z2amiller/ocn-LCD/FABLOG.md

# Fab Log

| Date | Board | Rev | Gen | Gerber SHA256 | JLC Order # | Notes |
|---|---|---|---|---|---|---|
| 2026-10-07T20:06 | ocn-LCD | 0.1 | 2 | ee7b4f2be727 | | |
| 2026-11-05T18:08 | ocn-LCD | 0.2 | 3 | 35a1b2744513 | | |
| 2026-11-05T18:33 | ocn-LCD | 0.2 | 4 | 9f6a66332300 | | |
| 2026-11-05T19:47 | ocn-LCD | 0.2 | 5 | 936187ad2718 | | |
| 2026-11-06T17:15 | ocn-LCD | 0.2 | 6 | 7f4fd457bffb | | |
