z2amiller/ocn-LCD/docs/ORDERING.md

# Ordering assembled boards from JLCPCB

JLCPCB can make the board and fit every surface-mount part. You only need three files from this
repo. On GitHub, open each one and use its download button:

- [`GERBER-ocn-LCD.zip`](../GERBER-ocn-LCD.zip): the board itself
- [`BOM-ocn-LCD.csv`](../jlcpcb/production_files/BOM-ocn-LCD.csv): the parts list, with an LCSC part number for each part
- [`CPL-ocn-LCD.csv`](../jlcpcb/production_files/CPL-ocn-LCD.csv): where each part goes on the board

Five assembled boards came to about $49 in November 2026, before shipping. JLC doesn't fit the LCD,
the programming header or the battery. Those come afterwards; see [Assembly](../README.md#assembly)
in the README.

## 1. Upload the gerber zip

Start at [jlcpcb.com](https://jlcpcb.com) and add `GERBER-ocn-LCD.zip`. The size and layer count fill
in from the file.

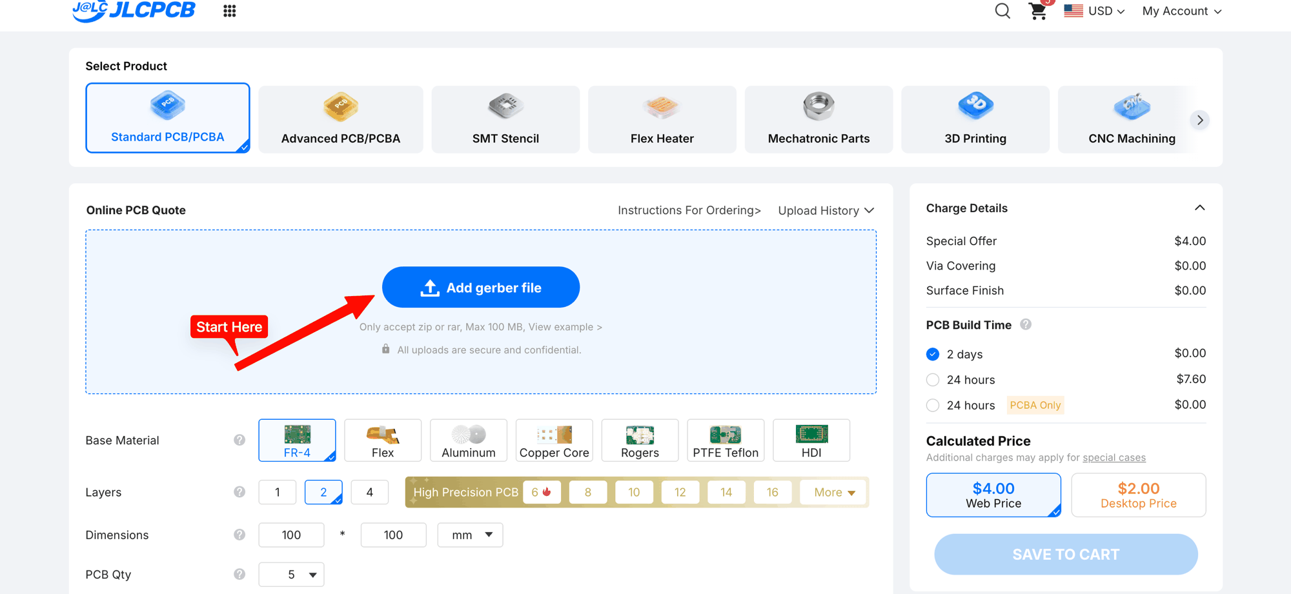
[picture p3: docs/ordering/01-upload-gerber.png]
Add gerber file


## 2. Board options

Change the surface finish to **LeadFree HASL**. Leave everything else at its default. You can pick
another soldermask colour if you like.

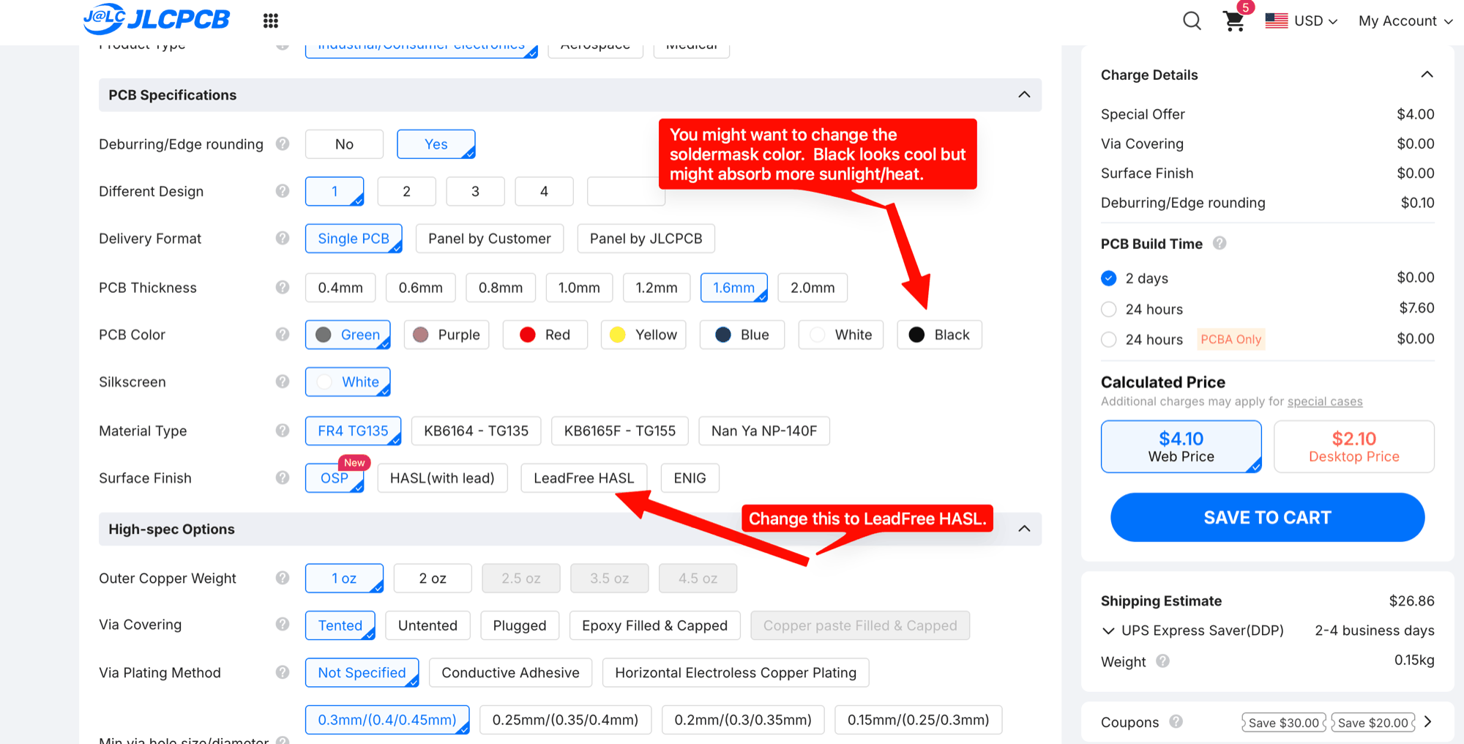
[picture p4: docs/ordering/02-pcb-options.png]
PCB specifications


## 3. Optional: a QR code serial number

The back of the board has an 8 × 8 mm silkscreen box. Choose **2D barcode (Serial Number)** under
*Mark on PCB* and JLC prints a unique QR code in that box.

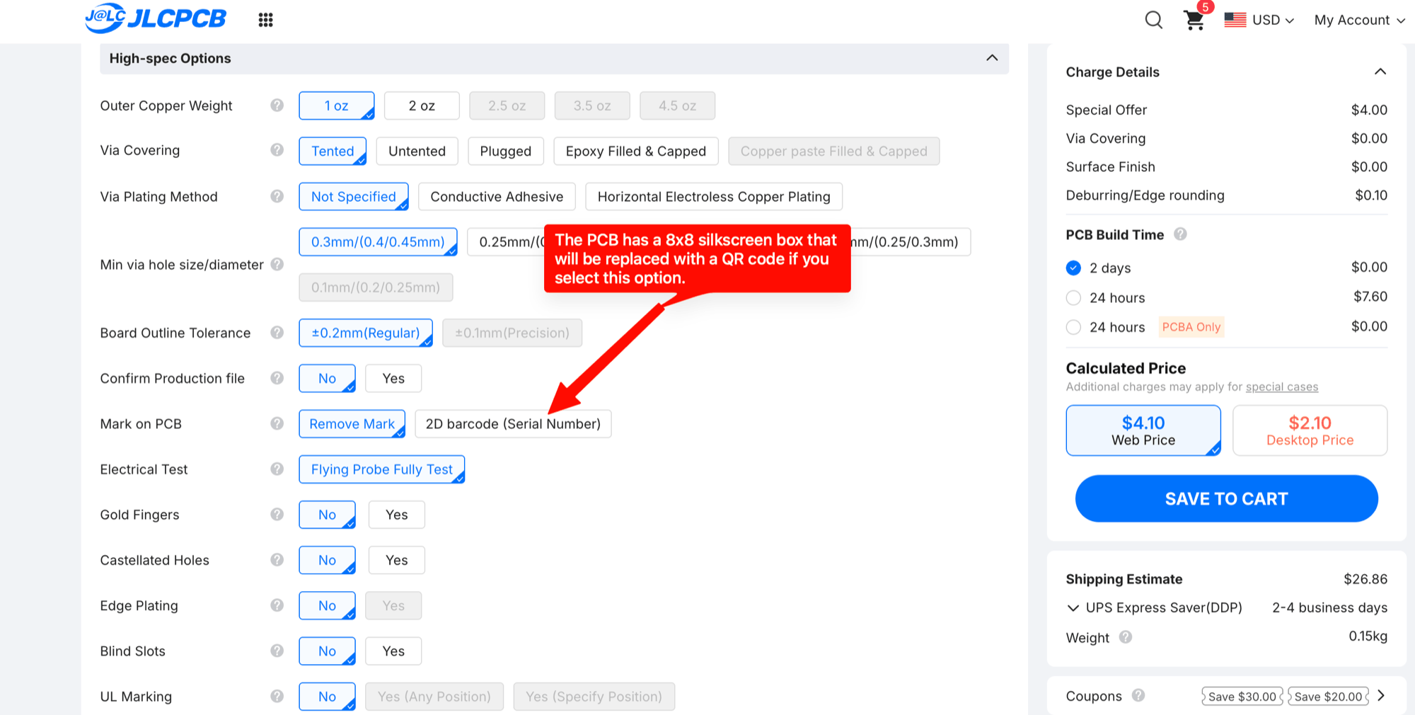
[picture p5: docs/ordering/03-mark-on-pcb.png]
Mark on PCB


In the dialog, pick **8\*8mm** and **Specify Position** so the code lands in the box. The prefix is
up to you.

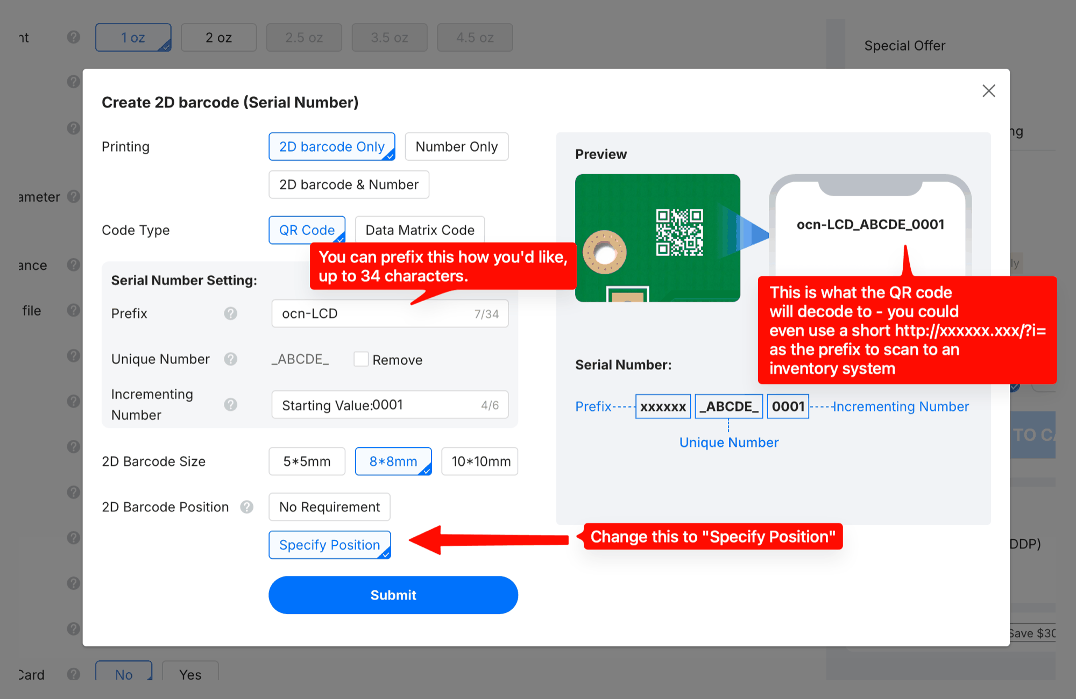
[picture p6: docs/ordering/04-serial-number.png]
2D barcode settings


## 4. Turn on assembly

Turn on the PCB Assembly switch. Choose **Economic**, **Top Side**, and the number of boards you
want assembled. If Economic isn't available, check that the board thickness and copper weight are
still at their defaults.

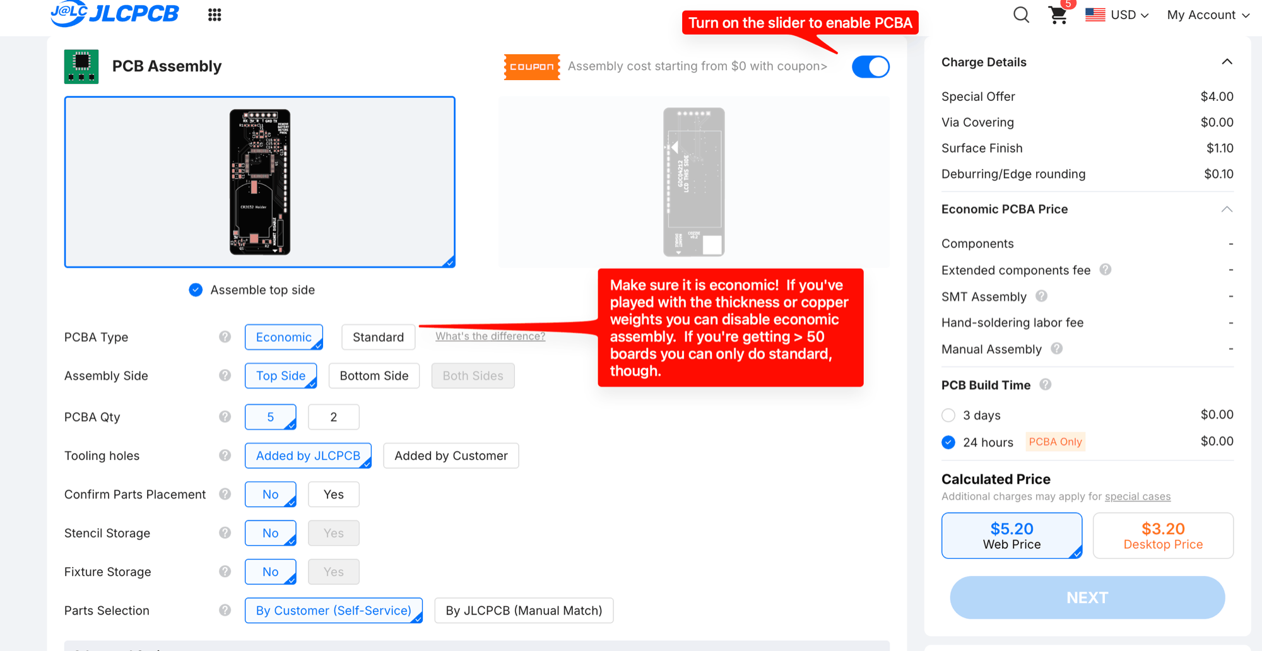
[picture p7: docs/ordering/05-pcb-assembly.png]
PCB Assembly options


## 5. Optional: approve JLC's work before they build

Two options make JLC wait for your approval before going ahead. Both are off by default.

- **Confirm Production file**, under *High-spec Options* in step 3. JLC sends you the board files
  after its engineers have processed them, and you approve them before the board is made.
- **Confirm Parts Placement**, under the assembly options in step 4. JLC's engineers check where and
  which way round each part sits, and send you a picture to approve before assembly.

Together they add about $1.50, plus however long you take to reply. The total in step 10 includes
both. The author leaves them off for these files, because they're already checked and step 9 shows
the placement anyway. They're worth turning on if you've changed the board.

## 6. Overview

The next page is a summary. Click **Next**.

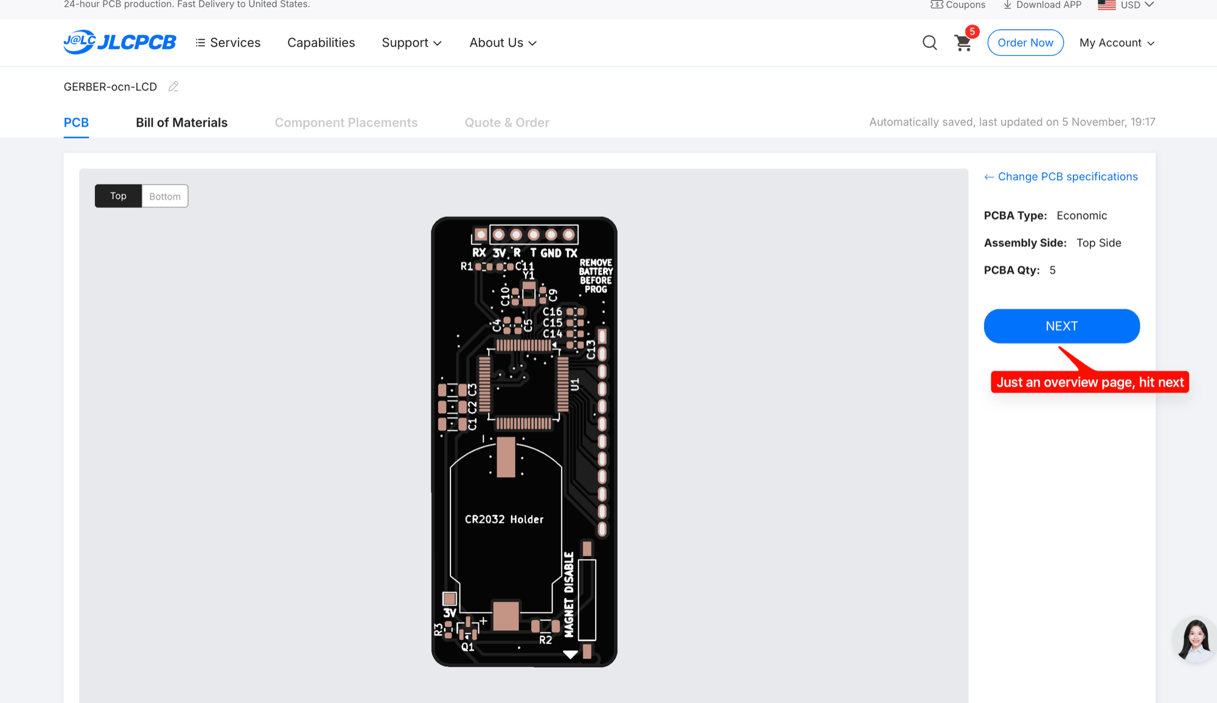
[picture p8: docs/ordering/06-overview.png]
Overview page


## 7. Upload the BOM and placement files

Add `BOM-ocn-LCD.csv` and `CPL-ocn-LCD.csv`, then click **Process BOM & CPL**.

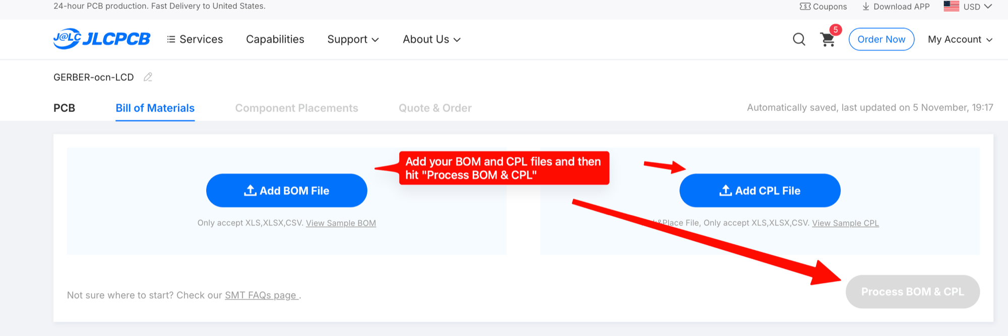
[picture p9: docs/ordering/07-upload-bom-cpl.png]
Add BOM and CPL files


## 8. Check the parts

All 12 lines should be matched, in stock and ticked. If a part is out of stock, find a replacement
on JLC's main parts search, which works better than the search on this page.

Two lines in the screenshot say *My Parts* because they came out of the author's own JLC stock. On
your order they will come from JLCPCB.

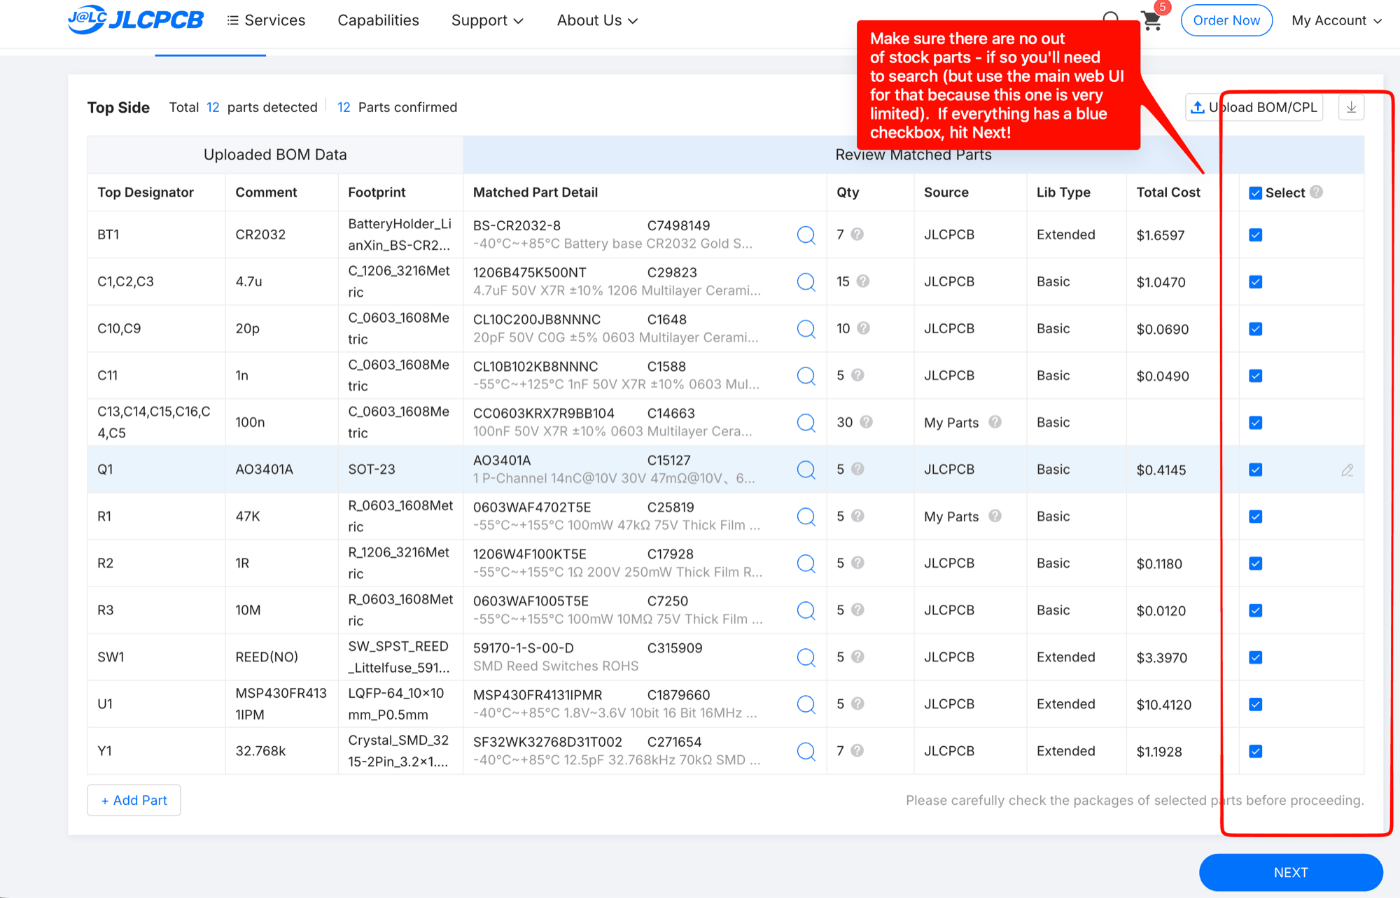
[picture p10: docs/ordering/08-check-parts.png]
Matched parts


## 9. Check the placement

Look over the preview for parts at the wrong angle, especially the transistor (Q1) and the
microcontroller (U1). To fix one, select it and press Space to turn it 90°.

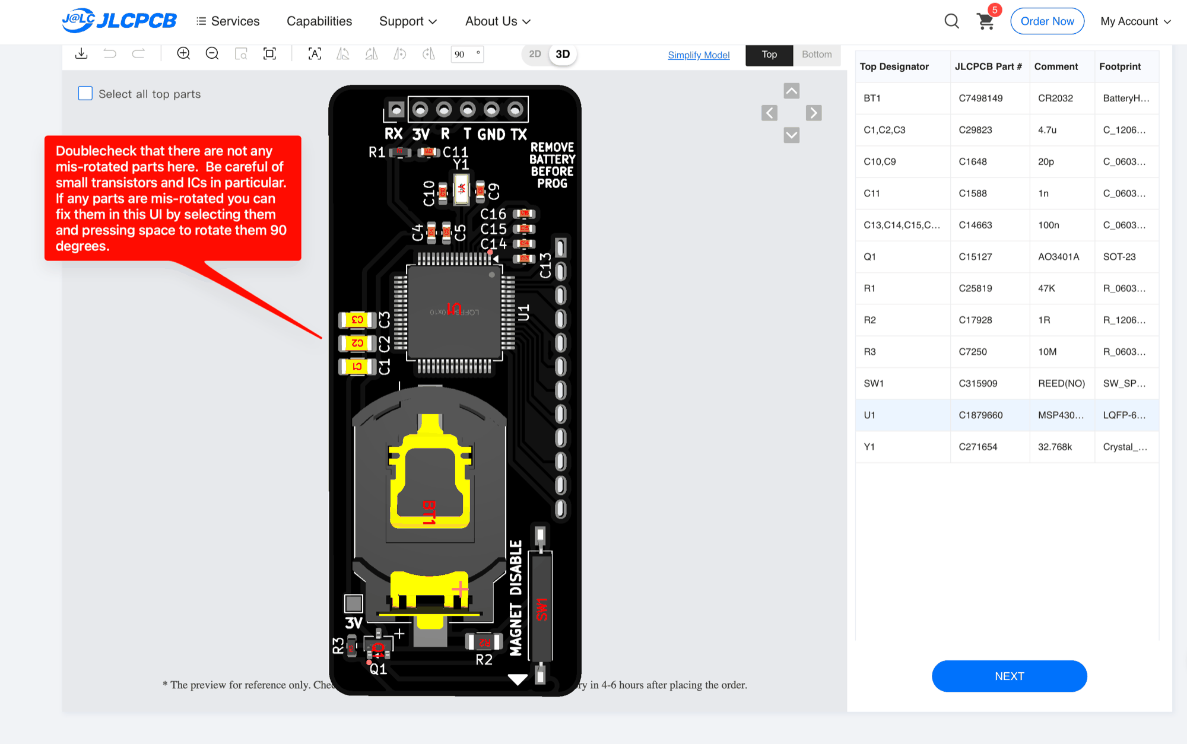
[picture p11: docs/ordering/09-check-placement.png]
Placement preview


## 10. Save to cart

The last page shows the total. You may need to choose a product description before it lets you save.
"Sensors → Clock" works. Then **Save to Cart** and check out as usual.

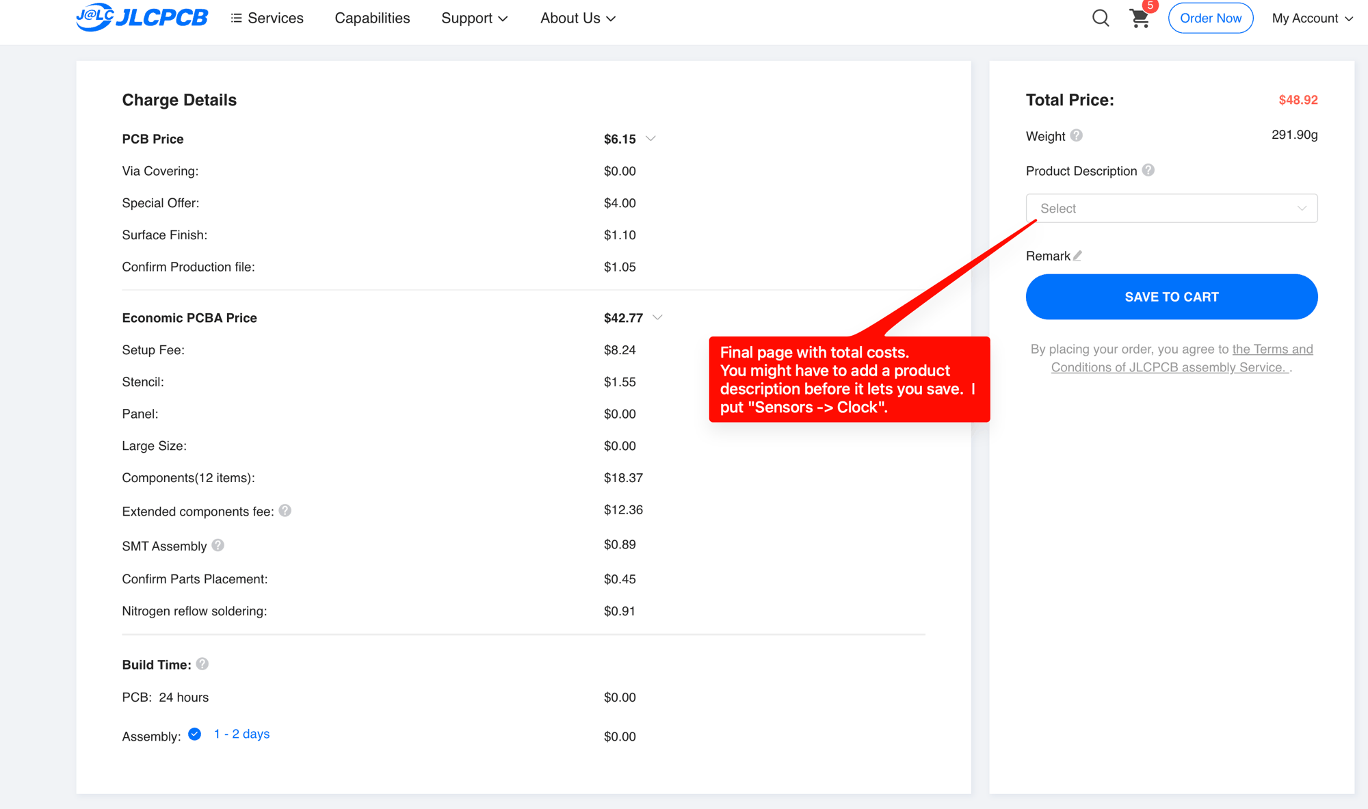
[picture p12: docs/ordering/10-total.png]
Charge details
