z2amiller/ocn-LCD/jlcpcb/production_files/BOM-ocn-LCD.csv

Comment | Designator | Footprint | LCSC | Quantity
100n | C13,C14,C15,C16,C4,C5 | C_0603_1608Metric | C14663 | 6
10M | R3 | R_0603_1608Metric | C7250 | 1
1R | R2 | R_1206_3216Metric | C17928 | 1
1n | C11 | C_0603_1608Metric | C1588 | 1
20p | C10,C9 | C_0603_1608Metric | C1648 | 2
32.768k | Y1 | Crystal_SMD_3215-2Pin_3.2x1.5mm | C271654 | 1
4.7u | C1,C2,C3 | C_1206_3216Metric | C29823 | 3
47K | R1 | R_0603_1608Metric | C25819 | 1
AO3401A | Q1 | SOT-23 | C15127 | 1
CR2032 | BT1 | BatteryHolder_LianXin_BS-CR2032-8_1x2032 | C7498149 | 1
GDC04212 | DS1 | LCD_GDC04212_1x12_P2.54mm | C9900333183 | 1
MSP430FR4131IPM | U1 | LQFP-64_10x10mm_P0.5mm | C1879660 | 1
REED (NO) | SW1 | SW_SPST_REED_Littelfuse_59170_GullWing | C315909 | 1
