z2amiller/ocn-LCD/ocn-LCD.kicad_pcb

## KiCad design ocn-LCD.kicad_pcb (2026-11-07)

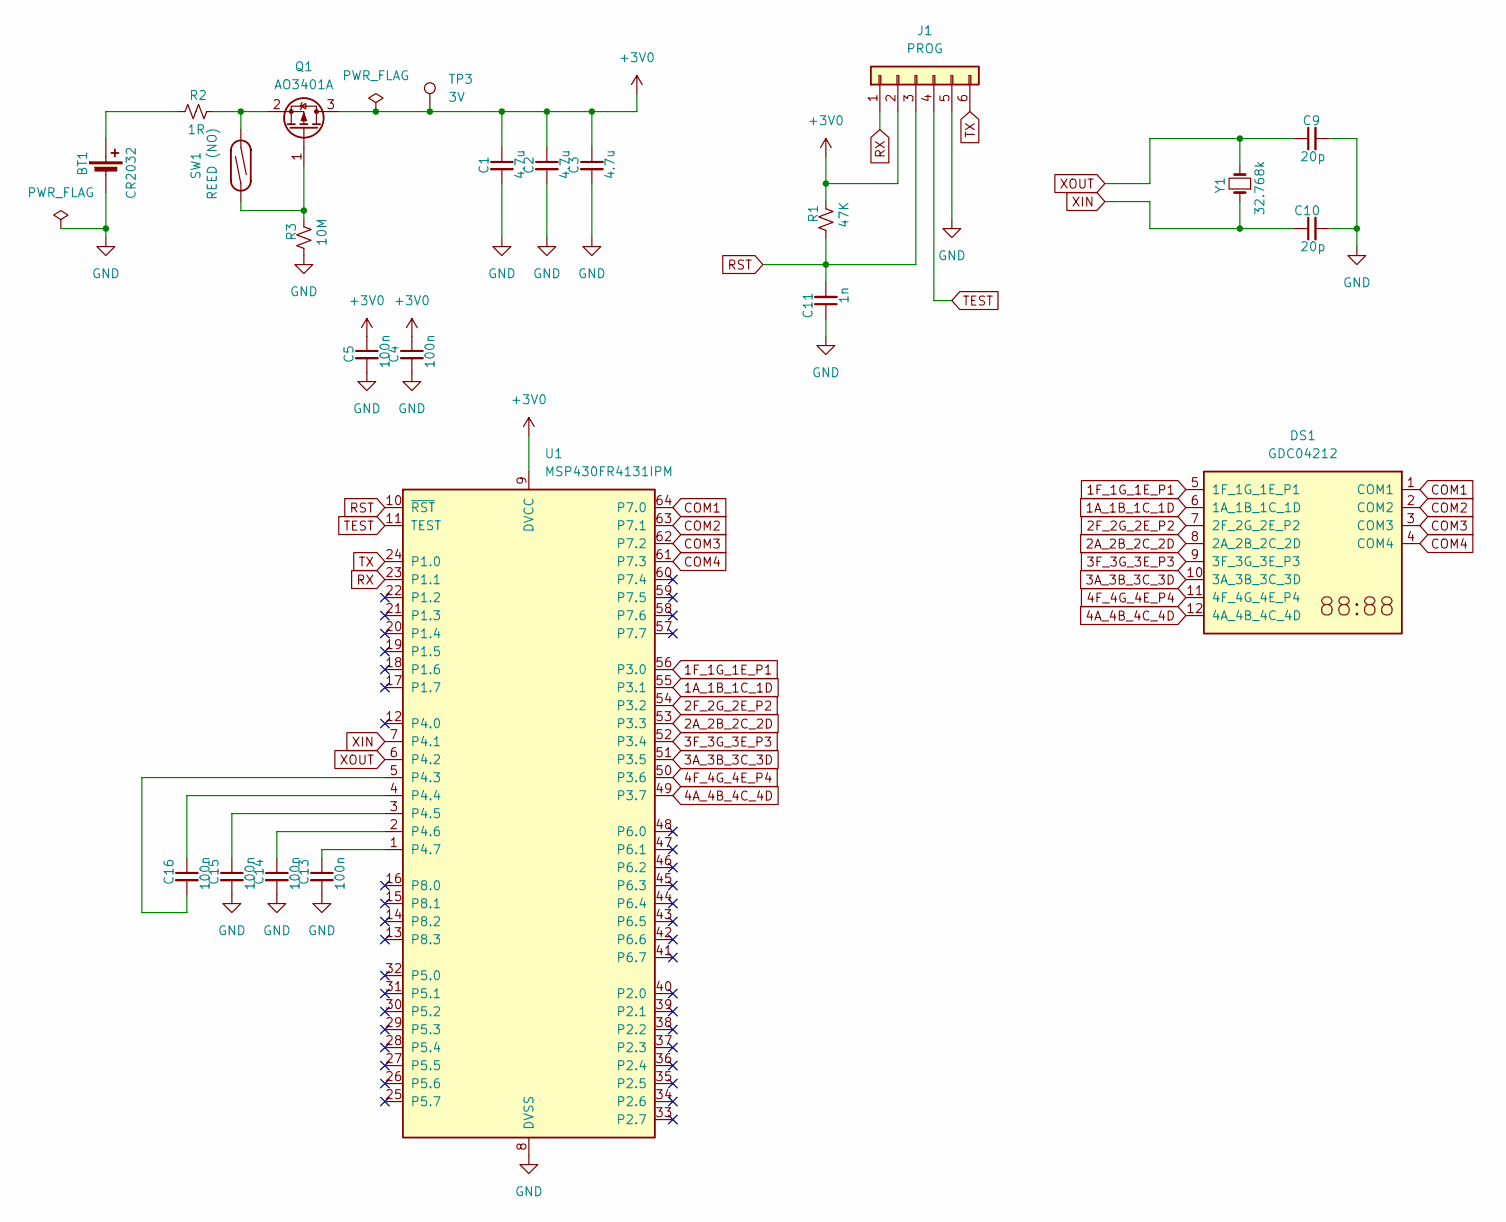
[picture p13: schematic ocn-LCD.kicad_sch]

Parts:
BT1: CR2032; BatteryHolder_LianXin_BS-CR2032-8_1x2032; LCSC C7498149
C1, C2, C3: 4.7u; C_1206_3216Metric; LCSC C29823
C4, C5, C13, C14, C15, C16: 100n; C_0603_1608Metric; LCSC C14663
C9, C10: 20p; C_0603_1608Metric; LCSC C1648
C11: 1n; C_0603_1608Metric; LCSC C1588
DS1: GDC04212; LCD_GDC04212_1x12_P2.54mm
J1: PROG; PinHeader_1x06_P2.54mm_Vertical
Q1: AO3401A; SOT-23; LCSC C15127
R1: 47K; R_0603_1608Metric; LCSC C25819
R2: 1R; R_1206_3216Metric; LCSC C17928
R3: 10M; R_0603_1608Metric; LCSC C7250
SW1: REED (NO); SW_SPST_REED_Littelfuse_59170_GullWing; LCSC C315909
TP3: 3V; TestPoint_Pad_1.5x1.5mm
U1: MSP430FR4131IPM; LQFP-64_10x10mm_P0.5mm; LCSC C1879660
Y1: 32.768k; Crystal_SMD_3215-2Pin_3.2x1.5mm; LCSC C271654

Connections:
1A_1B_1C_1D: DS1.6 (1A_1B_1C_1D), U1.55 (P3.1)
1F_1G_1E_P1: DS1.5 (1F_1G_1E_P1), U1.56 (P3.0)
2A_2B_2C_2D: DS1.8 (2A_2B_2C_2D), U1.53 (P3.3)
2F_2G_2E_P2: DS1.7 (2F_2G_2E_P2), U1.54 (P3.2)
3A_3B_3C_3D: DS1.10 (3A_3B_3C_3D), U1.51 (P3.5)
3F_3G_3E_P3: DS1.9 (3F_3G_3E_P3), U1.52 (P3.4)
4A_4B_4C_4D: DS1.12 (4A_4B_4C_4D), U1.49 (P3.7)
4F_4G_4E_P4: DS1.11 (4F_4G_4E_P4), U1.50 (P3.6)
+3V0: C1.1, C2.1, C3.1, C4.1, C5.1, J1.2, Q1.3 (D), R1.1, TP3.1 (1_1), U1.9 (DVCC)
COM1: DS1.1 (COM1), U1.64 (P7.0)
COM2: DS1.2 (COM2), U1.63 (P7.1)
COM3: DS1.3 (COM3), U1.62 (P7.2)
COM4: DS1.4 (COM4), U1.61 (P7.3)
GND: BT1.2 (-), C1.2, C2.2, C3.2, C4.2, C5.2, C9.2, C10.2, C11.1, C13.2, C14.2, C15.2, J1.5, R3.2, U1.8 (DVSS)
unnamed: BT1.1 (+), R2.2
unnamed: Q1.1 (G), R3.1, SW1.1
unnamed: Q1.2 (S), R2.1, SW1.2
unnamed: C16.2, U1.5 (P4.3)
unnamed: C16.1, U1.4 (P4.4)
unnamed: C15.1, U1.3 (P4.5)
unnamed: C14.1, U1.2 (P4.6)
unnamed: C13.1, U1.1 (P4.7)
RST: C11.2, J1.3, R1.2, U1.10 (~RST)
RX: J1.1, U1.23 (P1.1)
TEST: J1.4, U1.11 (TEST)
TX: J1.6, U1.24 (P1.0)
XIN: C10.1, U1.7 (P4.1), Y1.1
XOUT: C9.1, U1.6 (P4.2), Y1.2

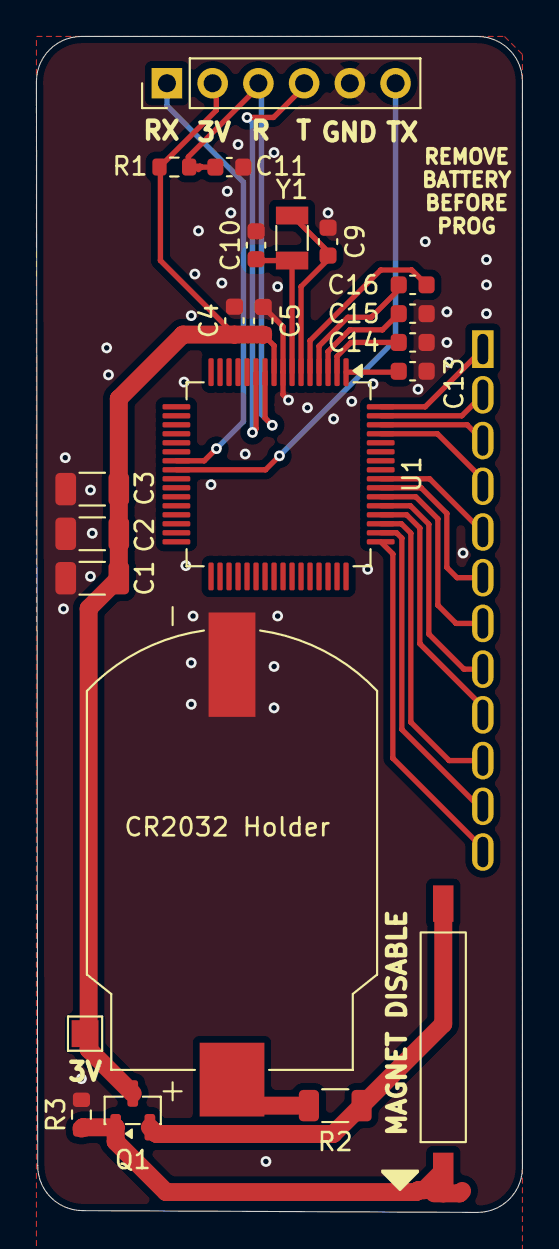
[picture p14: board ocn-LCD.kicad_pcb from above]

Board: 2 copper layers, 27.0 x 65.3 mm, 23 parts (1 on the bottom side), 28 nets.
