z2amiller/ocn-LCD/(commit log)

2026-10-02 ocn-LCD v0.1: coin-cell elapsed-time counter with LCD and magnetic off switch
    KiCad 10 project (MSP430FR4131, GDC04212 segment LCD, CR2032, normally open
    reed switch gating a P-channel MOSFET), with the board's own symbols and
    footprints in lib/ and project library tables pointing at them. README
    covers how it works, a power budget, magnet placement, key parts, assembly
    and programming over Spy-Bi-Wire from an MSP430 LaunchPad. Licensed
    CERN-OHL-P v2.
    [ocn-LCD.kicad_pcb, ocn-LCD.kicad_sch]
2026-10-08 ocn-LCD 0.1 fab outputs (g2)
    [ocn-LCD.kicad_pcb]
2026-10-11 Add the firmware under firmware/, MIT-licensed
    The MSP430FR4131 firmware: counts minutes from power-up as HH:MM, freezes at
    99:59, sleeps in LPM3.5 between once-a-minute RTC wakes, and blinks the colon
    from LCD blink memory. Drivers for the board's GDC04212 (from its spec sheet
    and the netlist, untested on glass) and for the FR4133 LaunchPad's LCD
    (tested), a Makefile for msp430-gcc and DSLite, and a PPK2 measurement script.
    The firmware is under the MIT License, since CERN-OHL-P is written for
    hardware; README and NOTICE say which licence covers what.
2026-10-11 firmware: driver for the 12-pin AliExpress glass (GLASS=maithoga)
    An alternative to the GDC04212 for the same footprint: the "12PIN TN
    Positive 4-Digits Segment LCD Panel" (brand maithoga), 50.8 x 22.86 mm,
    1/4 duty, 1/3 bias, 3.0 V. Its pins line up with the GDC04212's and each
    digit still sits in LCDMEM[3 + n]; its commons run in reverse, which the
    segment table absorbs. It has no colon, so the decimal point between the
    hours and minutes blinks in its place. From the listing's drawing and pin
    table, cross-checked against an independent rebuild of the table; not yet
    run on real glass.
    [glass_maithoga.c]
2026-10-25 firmware: ppk.py measures in line with the board's own cell, and logs runs
    --ampere puts the PPK2 in ampere-meter mode, for measuring the board on its
    own CR2032 with R2 lifted and the PPK2 across its pads. It switches modes
    before setting the voltage, so VOUT is never driven against the cell. The
    voltage is still set because the calibration needs it, but below about
    50 uA it makes no difference.
    --csv writes 1 ms bins (mean, min, max) and --raw saves every sample as a
    .npy file, for charting a run afterwards. The once-a-second lines now buffer
    only the current second, instead of re-joining the whole run every second,
    which slowed down long runs.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
2026-11-06 Y1: TKD SF32WK32768D31T002 (C271654) in place of Epson C32346
    JLC sets needAuditFlag on C32346 ("Assembly Difficulty: High"), so an
    economic-PCBA order holds for review and may be moved to the advanced
    option at extra cost. None of the other 32.768 kHz crystals checked on
    2026-11-05 carries the flag, the Epson FC-135 siblings included.
    C271654 is the same 3.2 x 1.5 x 0.9 mm body. Its datasheet's suggested
    land (1.0 x 1.8 mm pads, 1.5 mm gap) matches the existing footprint, and
    JLC's footprint for it lies on the same axis as C32346's, so the CPL
    rotation is unchanged. It is 12.5 pF, which the 20 pF C9/C10 still suit.
    ESR is 80 kOhm max against 70 kOhm. The firmware leaves XT1DRIVE at its
    res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
    [ocn-LCD.kicad_pcb, ocn-LCD.kicad_sch]
2026-11-06 ocn-LCD 0.2 fab outputs (g3)
    [ocn-LCD.kicad_pcb]
2026-11-06 Track the JLC BOM and CPL (ocn-LCD-0.2-g4)
    jlcpcb/production_files/ is ignored, so the generation commits carried
    only the gerber zip at the root. These are the g4 BOM and CPL, from the
    same run as that zip (sha256 9f6a66332300, which the production_files
    copy matches). Now that they are tracked, the fab hook's `git add -A`
    over the project folder stages them in each later generation commit.
    [BOM-ocn-LCD.csv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]
2026-11-06 docs: JLCPCB ordering walkthrough from annotated screenshots
    docs/ORDERING.md takes an order through JLC's site screen by screen:
    gerber upload, LeadFree HASL, the optional QR serial in the 8 x 8 mm box
    on B.SilkS, Economic top-side assembly, BOM/CPL upload, and the parts
    and placement checks. The callouts are Andy's, drawn in Shottr. The
    screenshots are scaled to 2000 px and cut to 256 colours, 1.3 MB in all.
    The README gets an Ordering section and lists the fab files.
2026-11-06 ocn-LCD 0.2 fab outputs (g5)
    [BOM-ocn-LCD.csv, ocn-LCD.kicad_pcb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]
2026-11-07 ocn-LCD 0.2 fab outputs (g6)
    [BOM-ocn-LCD.csv, ocn-LCD.kicad_pcb, ocn-LCD.kicad_sch]
